TheBlueGem/Gamelab-Robot-Warriors/(commit log)

2016-09-08 Wireless logging
2016-09-16 Finalized Pid Algorithm testing
2016-09-16 Removed copy sensorTest
2016-09-23 Simplified PID algorithm
2016-09-27 Final Version PID Tracker
2016-09-29 updated Pid tracker to do line tracker things
2016-09-30 Added timer
2016-10-03 Start and stop timer added
2016-10-07 revert to a simpler time
    [PID_Tracker_Test.ino, Sensor_Test.ino, listener.ino]
2016-10-27 Finally fixed PID test to be the actual PID test and not the entire fkin program
    [Line_tracker_robot.ino, PID_Tracker_Test.ino, printf.h]
